Raulmora22/Kiboar/README.md

<p align="center">
    
</p>

Welcome to the **Kiboar**! This project provides a comprehensive collection of components, footprints, and symbols specifically designed to help you create custom mechanical keyboards using **KiCad**.

## Features

- 🔹 **Extensive Component Collection**: Includes a wide range of switches, diodes, microcontrollers, USB connectors, and more.
- 🌟 **High-Quality Footprints**: Carefully crafted footprints compatible with various switch types like Cherry MX, Kailh, and others.
- 🔄 **3D Models**: Accurate 3D models for visualizing your PCB designs in 3D.
- 📆 **Ready-to-Use Symbols**: Pre-made schematic symbols for quick integration into your projects.
- 💡 **Modular Design**: Easy to customize and expand according to your specific needs.

## Installation

1. **Clone the Repository**:

   ```bash
   git clone https://github.com/Raulmora22/Kiboar.git
   ```

2. **Add to KiCad**:

   - Open KiCad and go to **Preferences > Manage Symbol Libraries** and add the `Kiboar.kicad_sym`.
   - Open KiCad and go to **Preferences > Manage Footprints Libraries** and add all the files in `Kiboar/footprints`.
   - Open KiCad and go to **Preferences > Configure Paths** and add this name `KIBOAR_3DMODELS` and select the path of `Kiboar/3dmodels`.

## Contributing

Contributions are welcome! Feel free to submit pull requests, open issues, or suggest new components.

## Contact

If you have any questions or suggestions, feel free to open an issue on GitHub.
Happy designing and building awesome mechanical keyboards! ⌨️💪

# Resources

<h4>Some parts was found in random projects in github/gitlab or internet</h4>

- [Keyswitch Library](https://github.com/kiswitch/kiswitch/tree/main)
- [Marbastlib](https://github.com/ebastler/marbastlib)
- [Keyswitches.pretty](https://github.com/daprice/keyswitches.pretty)
- [Kicad-libraries](https://github.com/sszczep/kicad-libraries)
- [ScottoKicad](https://github.com/joe-scotto/scottokeebs/tree/main/Extras/ScottoKicad)
